HCN1222/CMU_Sensor_Motor_Lab/firmware/legacy_tinkercad/README.md

# Tinkercad 历史程序（不要上传到真实 Uno）

这些 `.ino` 是浏览器 Tinkercad 演示用的旧版本：使用协议 v1、分号结尾命令、旧 GP2Y0A21 表，部分版本用**数学模型代替 DC 编码器反馈**。团队已改用实物，不再使用 Tinkercad。

真实 Uno 只上传 [../hardware_controller/hardware_controller.ino](../hardware_controller/hardware_controller.ino)（由 `generate_sketches.py` 生成）。
