HCN1222/CMU_Sensor_Motor_Lab/calibration/ir_filter.csv

time_s | raw_cm | filtered_cm | notes
0.000 | 46.86 | 43.94 | stationary target; first pre-reset frame removed, time re-zeroed
0.100 | 47.06 | 46.98 | stationary target; first pre-reset frame removed, time re-zeroed
0.200 | 46.86 | 46.94 | stationary target; first pre-reset frame removed, time re-zeroed
0.300 | 47.06 | 46.71 | stationary target; first pre-reset frame removed, time re-zeroed
0.400 | 46.86 | 46.98 | stationary target; first pre-reset frame removed, time re-zeroed
0.500 | 48.82 | 47.76 | stationary target; first pre-reset frame removed, time re-zeroed
0.600 | 47.06 | 47.06 | stationary target; first pre-reset frame removed, time re-zeroed
0.700 | 39.13 | 45.39 | stationary target; first pre-reset frame removed, time re-zeroed
0.800 | 46.86 | 47.49 | stationary target; first pre-reset frame removed, time re-zeroed
1.000 | 46.86 | 45.28 | stationary target; first pre-reset frame removed, time re-zeroed
1.100 | 46.86 | 46.94 | stationary target; first pre-reset frame removed, time re-zeroed
1.200 | 47.06 | 46.98 | stationary target; first pre-reset frame removed, time re-zeroed
1.300 | 47.25 | 46.12 | stationary target; first pre-reset frame removed, time re-zeroed
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
