HCN1222/CMU_Sensor_Motor_Lab/calibration/slot.csv

reference | measured | split | notes
10 | 11 | validation | capture.py 2026-11-10 18:57; 10 slow beam breaks
10 | 10 | validation | capture.py 2026-11-10 18:58; 10 slow beam breaks
