HCN1222/CMU_Sensor_Motor_Lab/calibration/result_figure/ir_filter_raw_vs_filtered.png

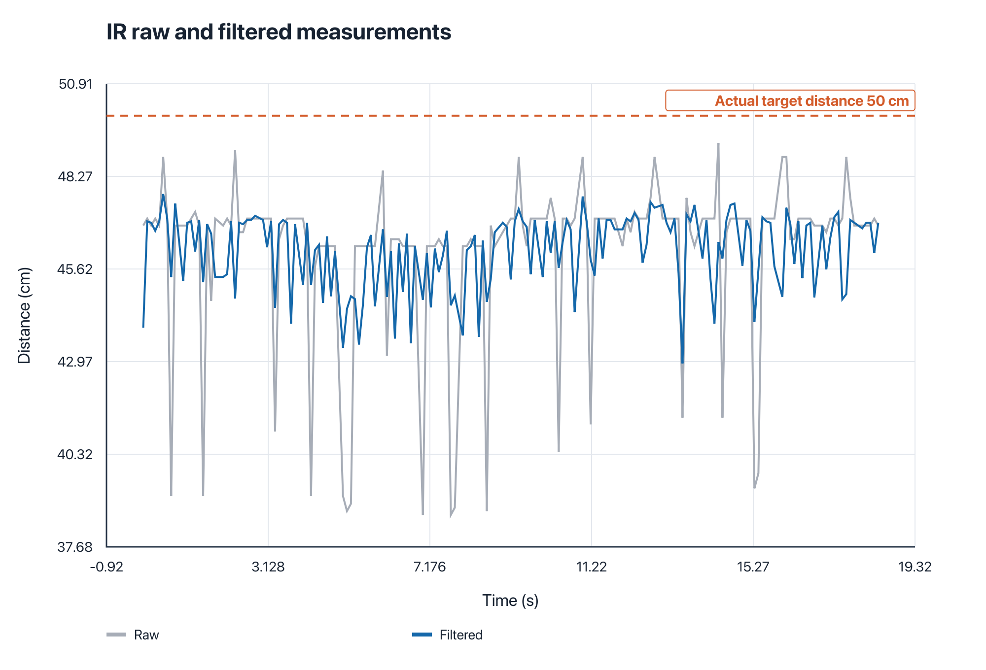
calibration/result_figure/ir_filter_raw_vs_filtered.png
