HCN1222/CMU_Sensor_Motor_Lab/calibration/result_figure/ir_transfer_function.png

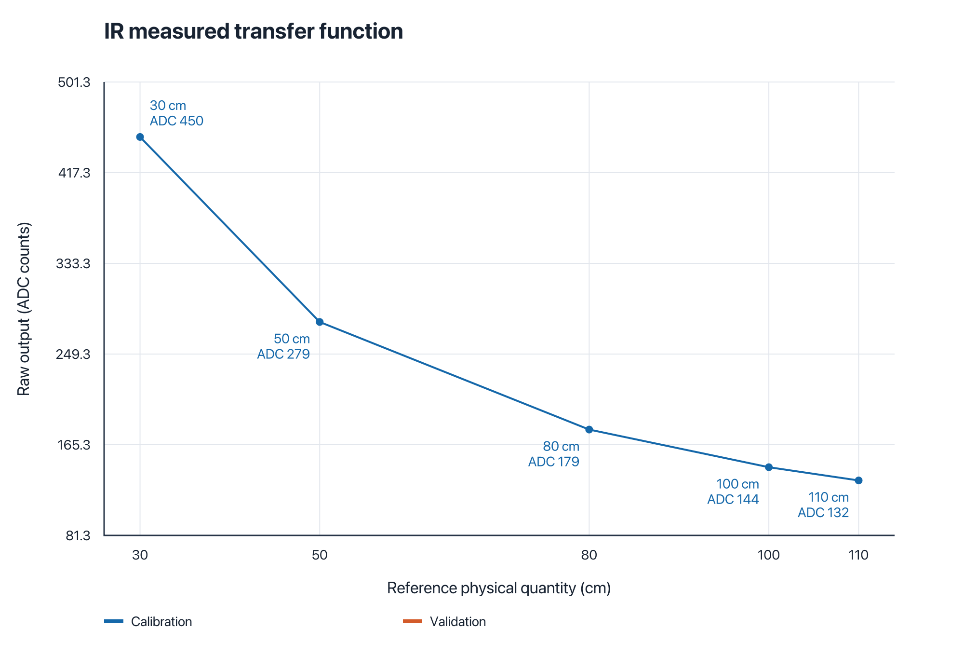
calibration/result_figure/ir_transfer_function.png
