HCN1222/CMU_Sensor_Motor_Lab/(commit log)

2026-11-12 feat: add top-level project folders (#4)
    ## Purpose
    Give each area a place in the repository from the start, so that
    teammates add their files to the same agreed folders instead of creating
    their own.
    ## Changes
    - Add `firmware/`, `ros2_ws/src/`, `hardware/`, `calibration/`,
    `tools/`, `docs/`, and `reference/`. Each holds an empty `.gitkeep`
    because Git does not track empty folders.
    - Add a "Repository layout" section to `README.md` that describes what
    each folder is for, and notes that a folder's `.gitkeep` should be
    deleted once the folder has real content.
    ## Validation
    - Checked that the diff against `main` contains only the seven
    `.gitkeep` files and the new README section.
    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
2026-11-12 feat: add sensor processing firmwarefirmware (#5)
    Add Arduino firmware for processing sensor measurements in the Sensor &
    Motor Control Lab.
    - Add firmware files for the sensor processing module.
    - Include support for the Sharp IR distance sensor and LV-MaxSonar-EZ
    ultrasonic sensor.
    - Implement sensor readings and serial output.
    - Hardware testing and sensor calibration are ongoing.
    ## Limitations & Follow-up
    - Further sensor calibration and integration testing may be required.
    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
2026-11-12 feat: add calibration analysis and unit tests (#7)
    Provide a reproducible way to turn sensor calibration measurements (IR, sonar, potentiometer, slot sensor) into firmware parameters and error statistics, before collecting real data.
    - Header-only CSV templates and a README describing the calibration / validation procedure. Error statistics use validation rows only, so fitted points are not used to claim accuracy.
    - `calibration/analyze.py`: fits calibration rows, reports per-sensor validation error (mean bias, MAE, RMSE, max), plots transfer curves and the IR filter comparison, and writes `hardware_config.h` suggestions without applying them.
    - `calibration/test_analy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
    [ir.csv, ir_filter.csv, pot.csv, slot.csv, sonar.csv]
2026-11-12 feat: add serial protocol and controller tests (#8)
    Add serial-protocol handling and host-side controller coverage so the
    ROS bridge and firmware share a validated protocol contract. No related
    issue.
    - Add a dependency-free serial protocol parser, encoder, data models,
    frame validation, and stream framer.
    - Add behavioral host tests for the shared firmware controller and its
    synthetic motor plant.
    - Passed 10 protocol behavior checks from
    `tests/python/test_protocol_link.py::ProtocolTests` against this branch
    protocol.py.
    - Passed `git diff --check`.
    - Blocked: `clang++ -std=c++11 -Wall -Wextra -Werror -pedantic
    tests/firmware/test_controller.cpp -o
    /pr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
    [protocol.py, test_controller.cpp]
2026-11-13 feat: add hardware wiring, integration tests and slot measurements (#9)
    Document the hardware setup and add integration checks for the
    sensor–motor system.
    - Add wiring documentation, component photos and a field checklist.
    - Add firmware-link and ROS integration tests, plus the test runner.
    - Add slot measurements, an error plot and D's test results.
    - Verified file structure and image paths.
    - Host E2E passed on the supplied project bundle using simulated inputs.
    - Update the outdated C++ configuration assertion and rerun the full
    suite.
    - ROS checks require the team's dependencies; physical stepper and
    system records rema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
    [slot.csv]
2026-11-13 feat: add sensor calibration measurements and results (#12)
    Report the team's measured conversion error for the IR rangefinder,
    ultrasonic rangefinder and potentiometer, and show the IR filter's noise
    reduction, using rows recorded on the Uno with `calibration/capture.py`.
    Depends on #11 (`capture.py`), which recorded these rows.
    - Measured data: `calibration/ir.csv` (30–110 cm), `ir_filter.csv` (167
    frames, fixed 50 cm target), `sonar.csv` (5 calibration + 3 validation
    rows, 30–100 cm), `pot.csv` (ADC at 0°, 90°, 180°). `slot.csv` is
    unchanged.
    - `calibration/results_20261112/`: full `analyze.py` output (transfer
    curves, IR filter plot, sonar and slot validati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
    [calibration_summary.csv, error_summary.csv, hardware_config_suggestion.txt, ir.csv, ir_filter.csv, pot.csv, sonar.csv]
2026-11-13 feat: add read-only serial capture for calibration (#11)
    Record calibration and validation rows directly from the Uno's telemetry
    instead of copying numbers from the Serial Monitor by hand, so rows in
    `calibration/*.csv` are averaged consistently and traceable to a capture
    run.
    - `calibration/capture.py`: opens the serial port, parses STATE/RAW
    frames with the shared `sensor_motor_lab.protocol` parser, averages a
    few seconds of paired frames and appends one row to
    `calibration/<sensor>.csv` (pot, IR, sonar, slot), or records an IR raw
    vs. filtered session to `ir_filter.csv`.
    - Read-only: it never sends a command, so the controller stays disarmed.
    - Telemetry is used on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
2026-11-13 Zeanw/feat/controller (#15)
    Explain the problem or research question and why this change is needed.
    Link related Issues, if any.
    - Summarize the main changes and important design decisions.
    - List checks or experiments actually run, relevant commands, and
    observed results.
    - If validation was not run or was only partial, explain why and what
    remains unverified.
    - List known limitations, effects on other modules, dependencies, or
    remaining work.
    - Write "None" if there are none.
    ## Experiment Details
    - Hypothesis and method/baseline:
    - Code commit, configuration, and random seeds:
    - Data source/version and relevant environment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
    [host_cli.cpp, test_controller.cpp]
2026-11-13 feat: add firmware validation (#16)
    Validate the Arduino Uno firmware and sensor processing functionality to
    ensure reliable hardware operation and accurate sensor measurements.
    - Validate Arduino Uno firmware compilation and hardware compatibility.
    - Test Sharp IR and MaxSonar ultrasonic sensor readings.
    - Verify sensor data processing, filtering, and serial communication.
    - Check sensor calibration, pin configurations, and integration with the
    Arduino controller.
    - Successfully compiled the firmware for Arduino Uno.
    - Performed initial sensor measurement and serial output testing.
    - Verified basic sensor functionality; full system integration and
    calib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
2026-11-13 feat: add Arduino firmware and sensor validation (#17)
    - Data source/versi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
2026-11-13 feat: add protocol and bridge tests (#14)
    Complete C2 host-side validation for the serial protocol, bridge safety
    callbacks, and the controller configuration contract. No related issue.
    - Add protocol/link/operator-lease tests and bridge callback tests that
    run without ROS middleware or an Uno.
    - Align controller-test expectations with the current verified hardware
    gate and assert the measured encoder sign is -1.
    - Document the focused test command and record actual validation results
    and limitations.
    - Passed: `PYTHONPATH=ros2_ws/src/sensor_motor_lab python3 -m unittest
    discover -s tests/python -p test_*.py -v` ran 29 tests successfully; one
    optional ps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
    [test_bridge_logic.py, test_controller.cpp, test_protocol_link.py]
