HCN1222/CMU_Sensor_Motor_Lab/hardware/images/power-supply.jpg

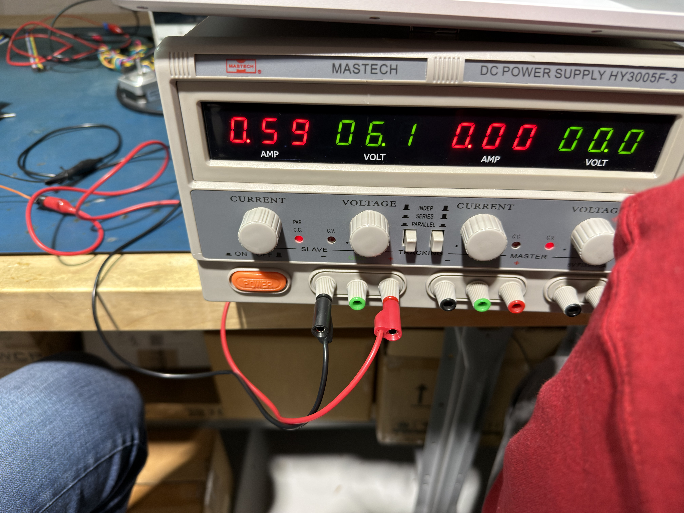
[picture p2: hardware/images/power-supply.jpg]
hardware/images/power-supply.jpg
